3cky/fancontrol/Schematic/fancontrol_attiny.png

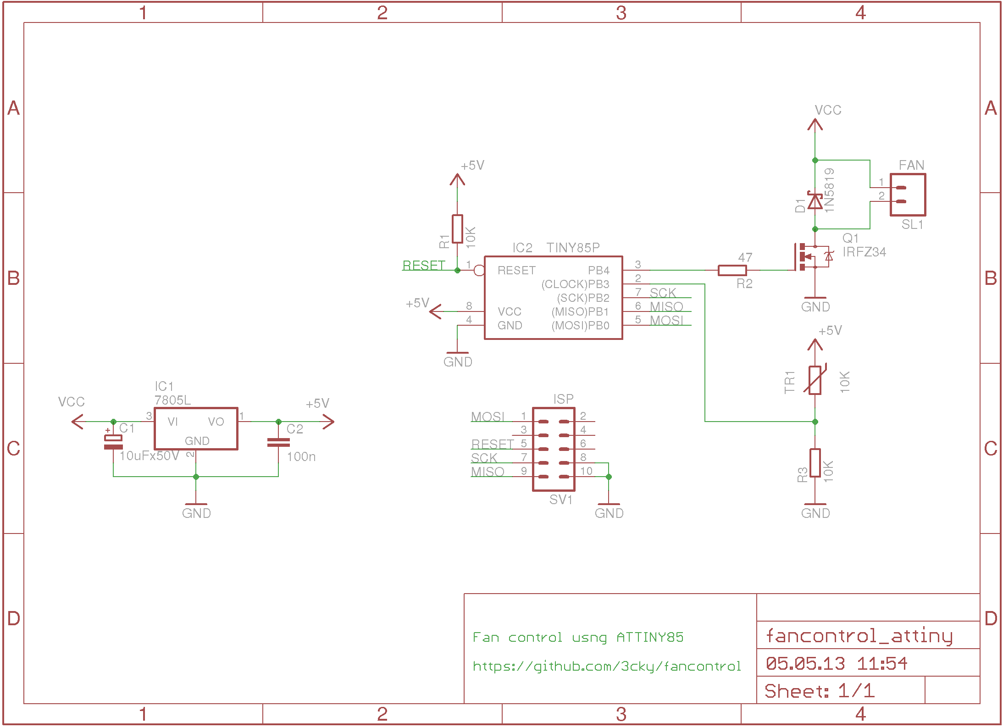
Schematic/fancontrol_attiny.png
