3cky/fancontrol/Schematic/fancontrol_attiny.sch

## EAGLE design Schematic/fancontrol_attiny.sch (2013-05-06)

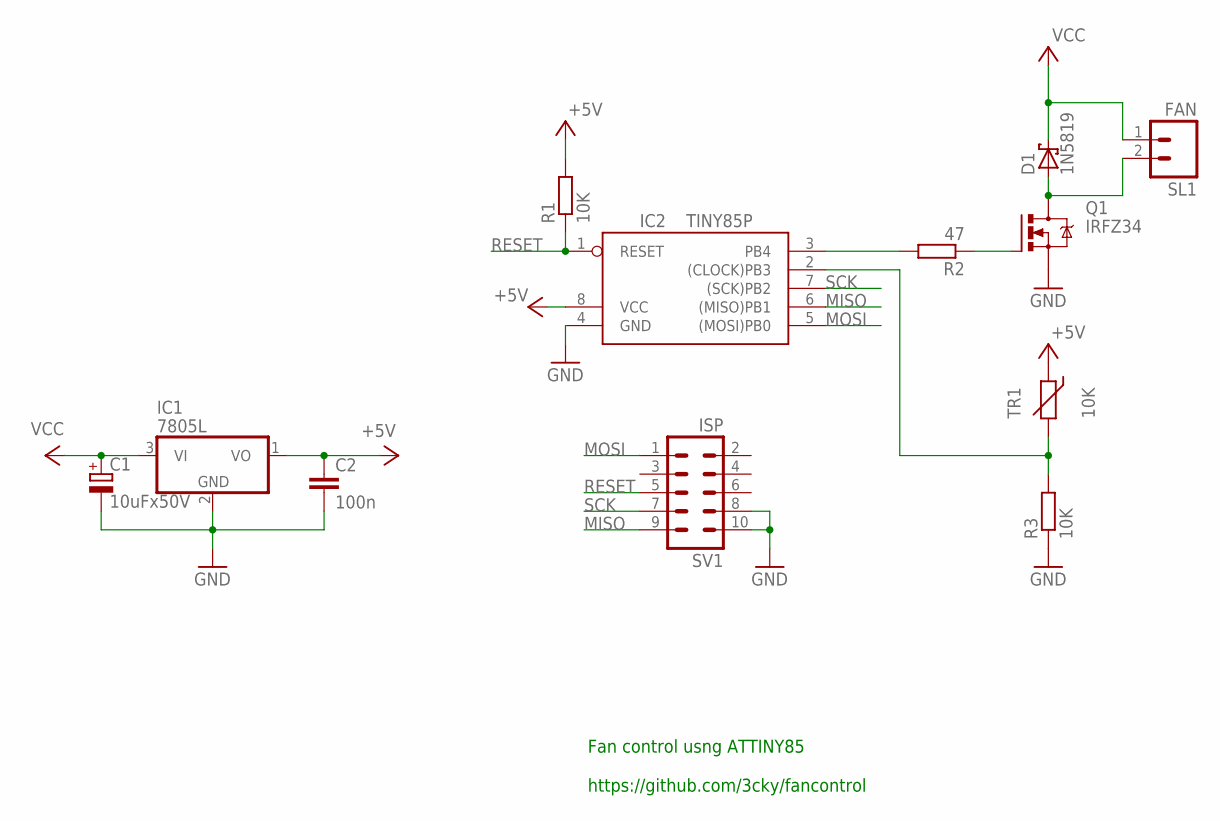
[picture p2: schematic fancontrol_attiny.sch]

Parts:
C1: 10uFx50V; E5-5
C2: 100n; C025-024X044
D1: 1N5819; DO41-7.6
IC1: 7805L; TO92
IC2: TINY85P; DIL08
Q1: IRFZ34; TO220BH
R1, R3: 10K; M0805
R2: 47; M0805
SL1: FAN; 02P
SV1: ISP; MA05-2
TR1: 10K; R-5

Connections:
+5V: C2.1, IC1.1 (VO), IC2.8 (VCC), R1.2, TR1.1
GND: C1.-, C2.2, IC1.2 (GND), IC2.4 (GND), Q1.S, R3.1, SV1.8, SV1.10
MISO: IC2.6 ((MISO)PB1), SV1.9
MOSI: IC2.5 ((MOSI)PB0), SV1.1
unnamed: IC2.2 ((CLOCK)PB3), R3.2, TR1.2
unnamed: IC2.3 (PB4), R2.2
unnamed: Q1.G, R2.1
unnamed: D1.A, Q1.D, SL1.2
RESET: IC2.1 (RESET), R1.1, SV1.5
SCK: IC2.7 ((SCK)PB2), SV1.7
VCC: C1.+, D1.C, IC1.3 (VI), SL1.1

Notes on the sheet:
Fan control usng ATTINY85 https://github.com/3cky/fancontrol
