3cky/fancontrol/(commit log)

2013-05-06 Initial sources import.
    [fancontrol_attiny.sch]
2013-05-09 PWM output now set by ADC interrupt routine, so no more Timer 1 overflow ISR is needed. PWM output frequency is increased up to 125 kHz. Fuses are reconfigured to CPU clocked at 1 MHz. Added thermist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
    [10kThermistorTable.ods]
